anushka5531/Jarvis-March-Algorithm/(list of files, drawings)

Other design files:
finaljama[1].pdsprj
